m293732/csce_462_project/models/bottom view.png

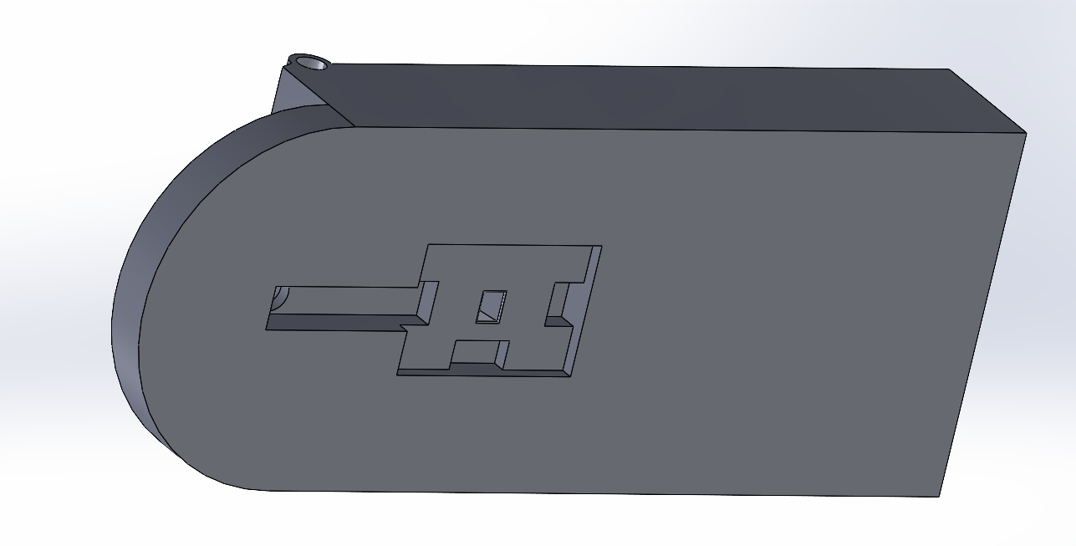
models/bottom view.png
