m293732/csce_462_project/models/top view.png

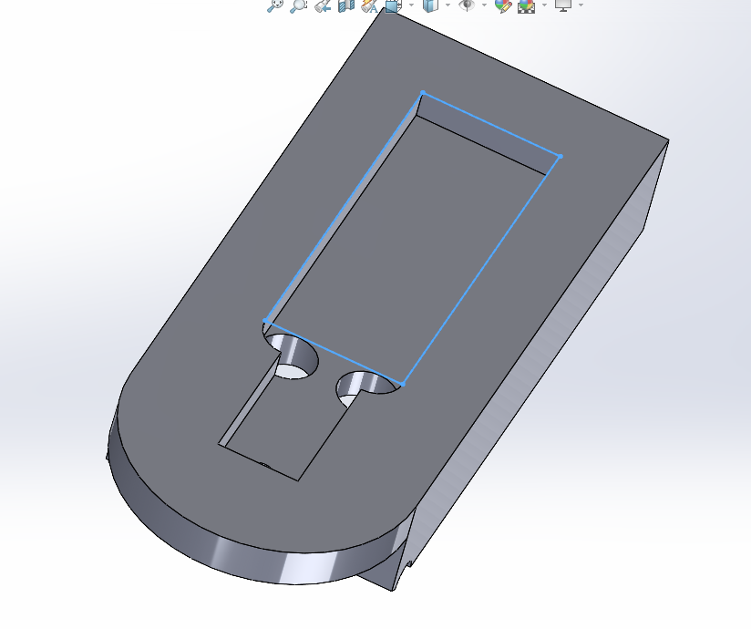
models/top view.png
