m293732/csce_462_project/models/Part1.SLDPRT

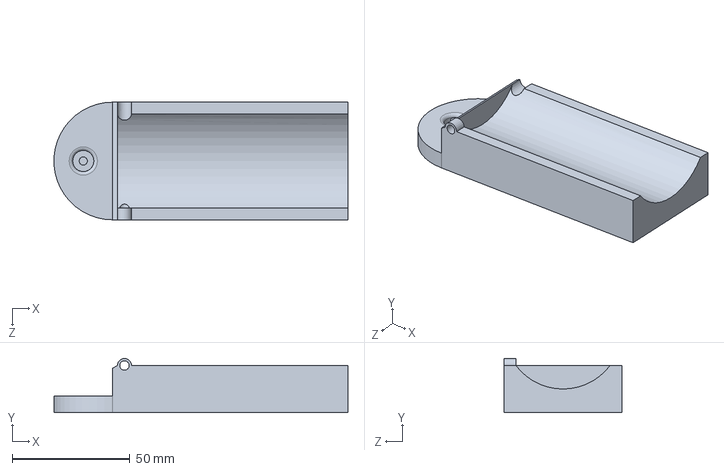
[picture p9: CAD file, 2022-11-28]
models/Part1.SLDPRT
124.9 x 23.0 x 50.0 mm
