m293732/csce_462_project/models/Top piece.SLDPRT

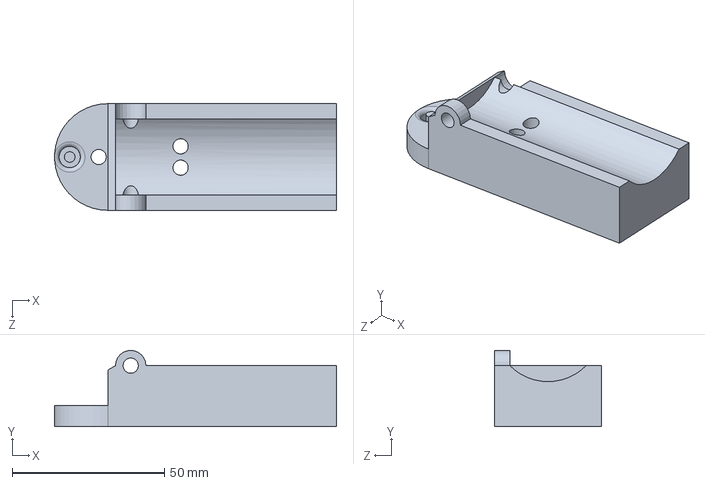
[picture p10: CAD file, 2022-11-28]
models/Top piece.SLDPRT
92.5 x 25.0 x 35.0 mm
