m293732/csce_462_project/models/AI3M_Bottom piece.curaproject.3mf

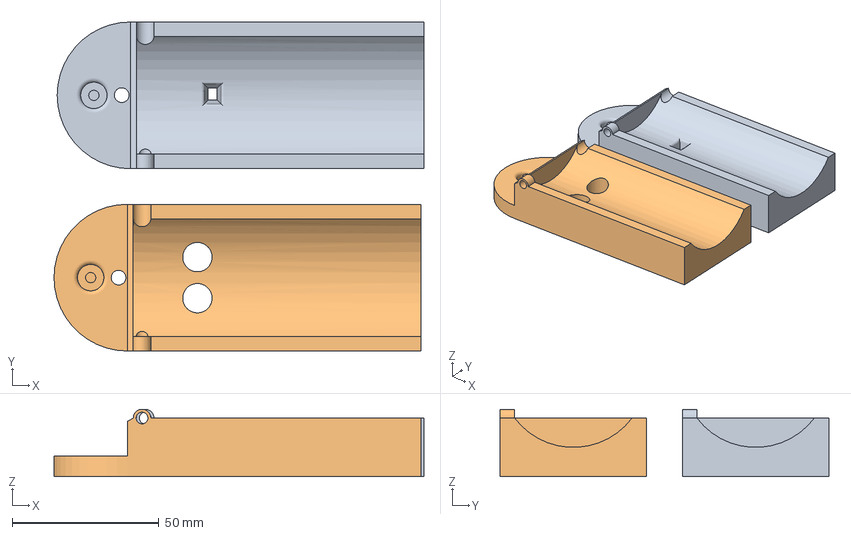
[picture p11: CAD file, 2022-11-28]
models/AI3M_Bottom piece.curaproject.3mf
126.1 x 112.1 x 23.0 mm
