m293732/csce_462_project/(list of files, cad)

Other CAD files:
models/Bottom piece.SLDPRT
models/Bottom piece.STL
models/Top piece.STL
