m293732/csce_462_project/(commit log)

2022-10-28 added work plan, sensor data sheet, arduino libraries & empty code file
2022-11-06 working display & light sensor code
2022-11-28 relocated files
    [AI3M_Bottom piece.curaproject.3mf, Bottom piece.SLDPRT, Bottom piece.STL, Part1.SLDPRT, Top piece.SLDPRT, Top piece.STL]
2022-11-28 relocated files again
    [AI3M_Bottom piece.curaproject.3mf, Bottom piece.SLDPRT, Bottom piece.STL, Part1.SLDPRT, Top piece.SLDPRT, Top piece.STL]
2022-11-30 changes to printReadings function and max display value
